Printhatshit/Prusa-i3-PTS/Freecad/Cuerpo extrusor.FCStd

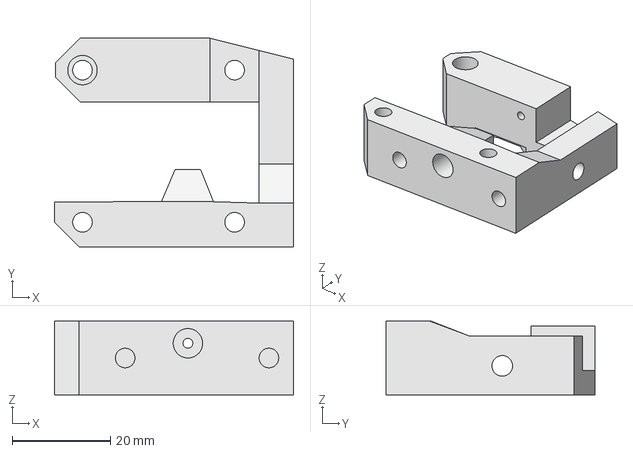
[picture p1: CAD file, 2015-06-19]
Freecad/Cuerpo extrusor.FCStd
48.7 x 42.5 x 15.0 mm
