Printhatshit/Prusa-i3-PTS/Stl/Prusa I3 PTS/Autolevel inductivo 16mm.stl

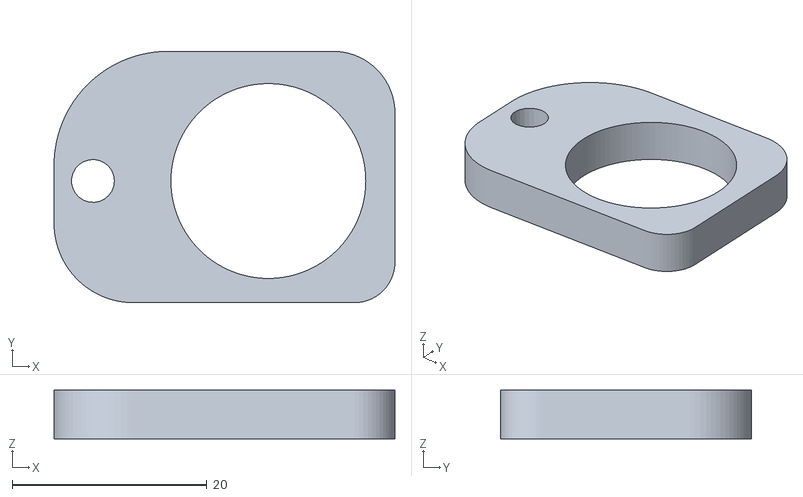
[picture p2: CAD file, 2015-07-31]
Stl/Prusa I3 PTS/Autolevel inductivo 16mm.stl
35.0 x 25.8 x 5.00
