Printhatshit/Prusa-i3-PTS/Stl/Prusa I3 PTS/Dual Extruder/X_carriage_dual_PTSone_extrude_A.stl

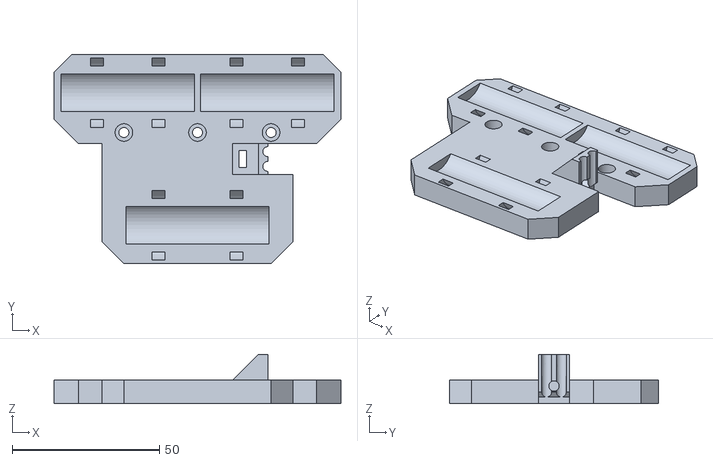
[picture p3: CAD file, 2015-01-19]
Stl/Prusa I3 PTS/Dual Extruder/X_carriage_dual_PTSone_extrude_A.stl
97.5 x 71.0 x 16.8
