Printhatshit/Prusa-i3-PTS/Stl/Prusa I3 PTS/Soporte bobina Filamento/soporte-bobina-printhatshit.stl

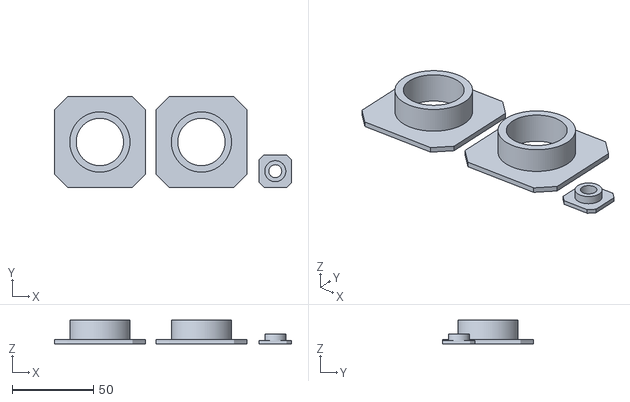
[picture p4: CAD file, 2015-09-02]
Stl/Prusa I3 PTS/Soporte bobina Filamento/soporte-bobina-printhatshit.stl
146.2 x 56.0 x 14.5
