Printhatshit/Prusa-i3-PTS/Freecad/Soporte Extrusor.FCStd

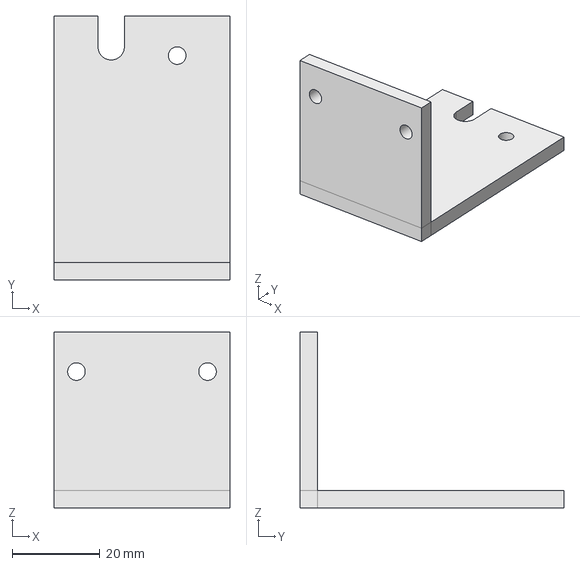
[picture p5: CAD file, 2015-06-16]
Freecad/Soporte Extrusor.FCStd
40.0 x 60.0 x 40.0 mm
