Printhatshit/Prusa-i3-PTS/Stl/Prusa I3 PTS/Dual Extruder/X_carriage_B.stl

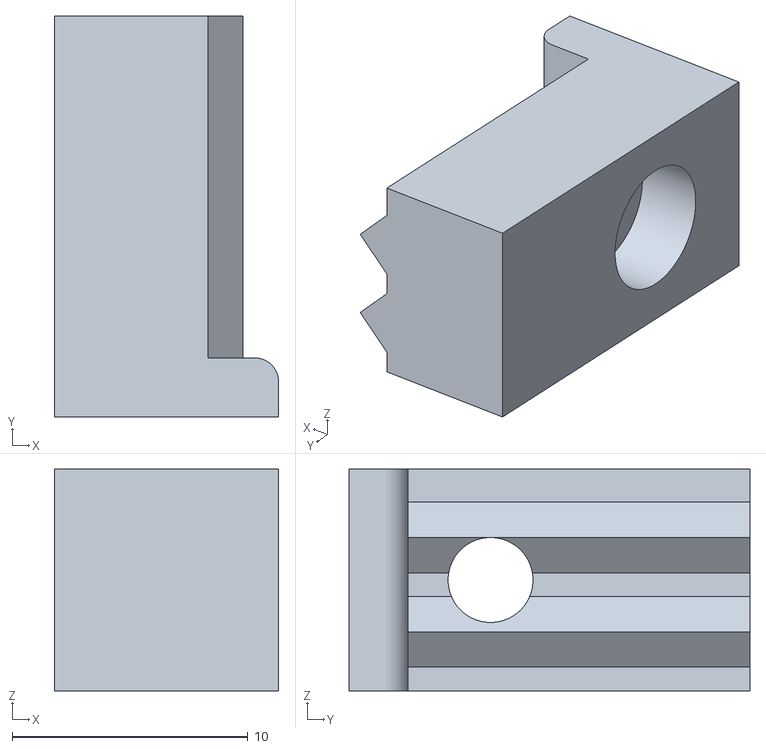
[picture p6: CAD file, 2015-01-13]
Stl/Prusa I3 PTS/Dual Extruder/X_carriage_B.stl
9.50 x 17.0 x 9.40
