Printhatshit/Prusa-i3-PTS/Stl/Prusa I3 PTS/lcd_front_Cover.stl

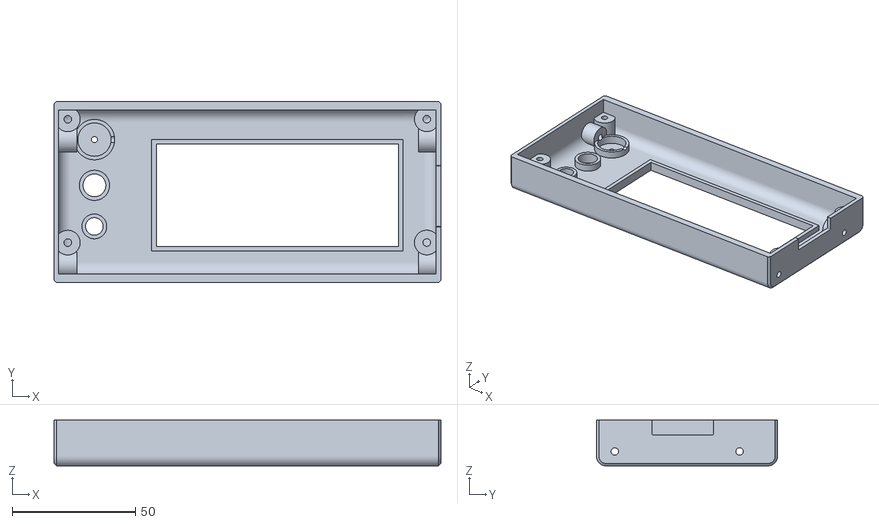
[picture p7: CAD file, 2015-06-12]
Stl/Prusa I3 PTS/lcd_front_Cover.stl
156.9 x 73.5 x 18.6
