Printhatshit/Prusa-i3-PTS/Stl/Prusa I3 PTS/Soporte bobina Filamento/soporte-bobina-m10.stl

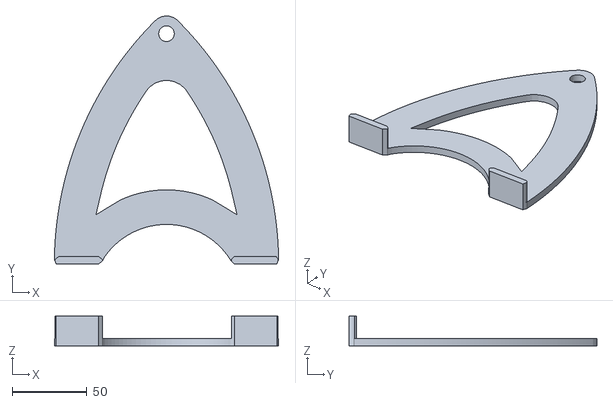
[picture p8: CAD file, 2015-06-17]
Stl/Prusa I3 PTS/Soporte bobina Filamento/soporte-bobina-m10.stl
150.0 x 165.9 x 20.0
