Printhatshit/Prusa-i3-PTS/Stl/Prusa I3 PTS/X_carriage_A_chain-M4-O .stl

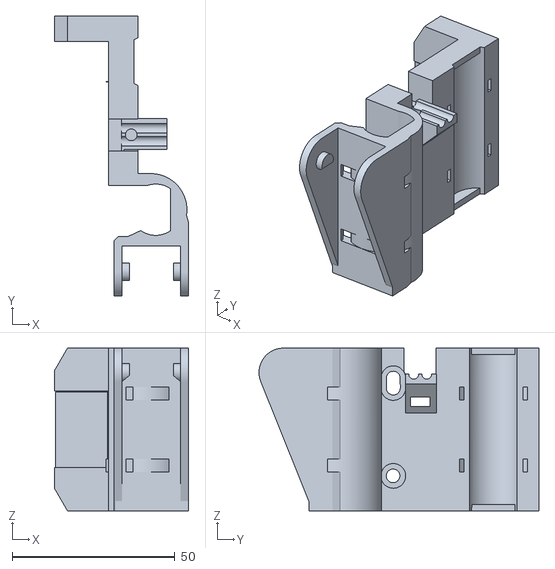
[picture p9: CAD file, 2015-06-12]
Stl/Prusa I3 PTS/X_carriage_A_chain-M4-O .stl
41.2 x 86.0 x 50.0
