Printhatshit/Prusa-i3-PTS/Stl/Prusa I3 PTS/lcd_Top_Case_FGD.stl

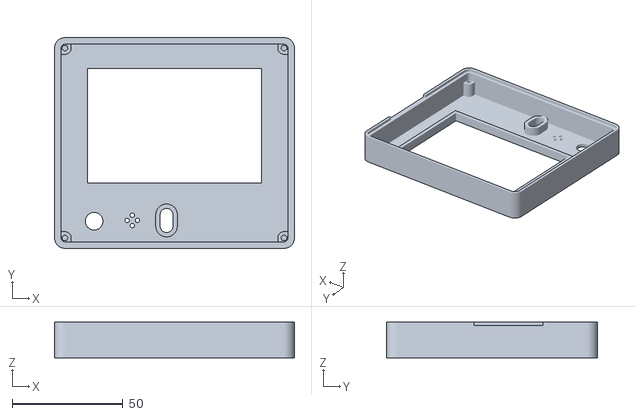
[picture p10: CAD file, 2015-03-03]
Stl/Prusa I3 PTS/lcd_Top_Case_FGD.stl
108.6 x 95.4 x 16.1
