Printhatshit/Prusa-i3-PTS/Stl/Prusa I3 PTS/y_tensioner_fixed_fixed.stl

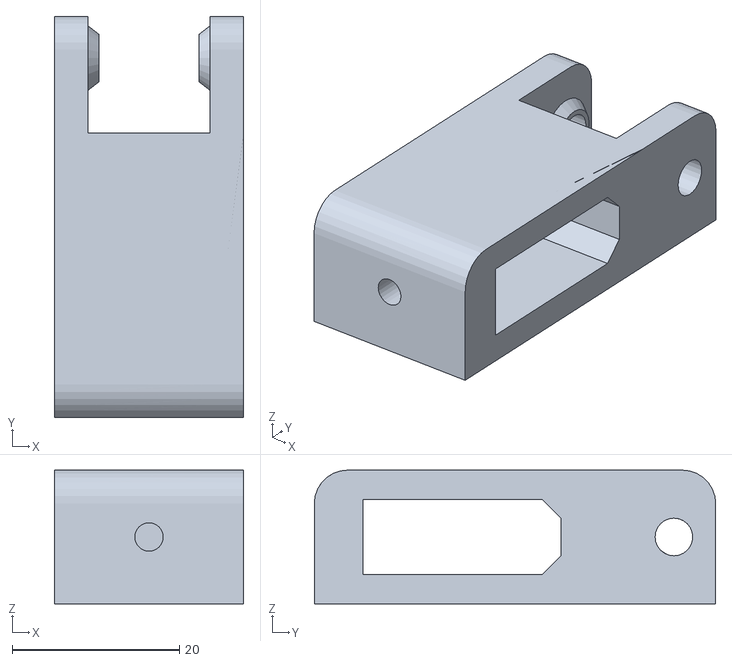
[picture p11: CAD file, 2015-03-03]
Stl/Prusa I3 PTS/y_tensioner_fixed_fixed.stl
22.6 x 48.0 x 16.0
