Printhatshit/Prusa-i3-PTS/Stl/Prusa I3 PTS/lcd_Bottom_Case_FGD_fixed.stl

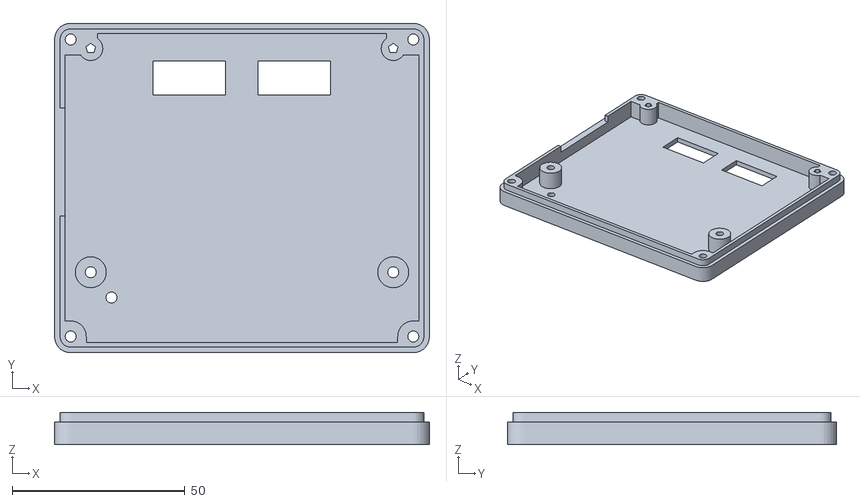
[picture p12: CAD file, 2015-03-03]
Stl/Prusa I3 PTS/lcd_Bottom_Case_FGD_fixed.stl
108.6 x 95.4 x 9.30
