Printhatshit/Prusa-i3-PTS/Stl/Prusa I3 PTS/X_carriage_A_chain_servo.stl

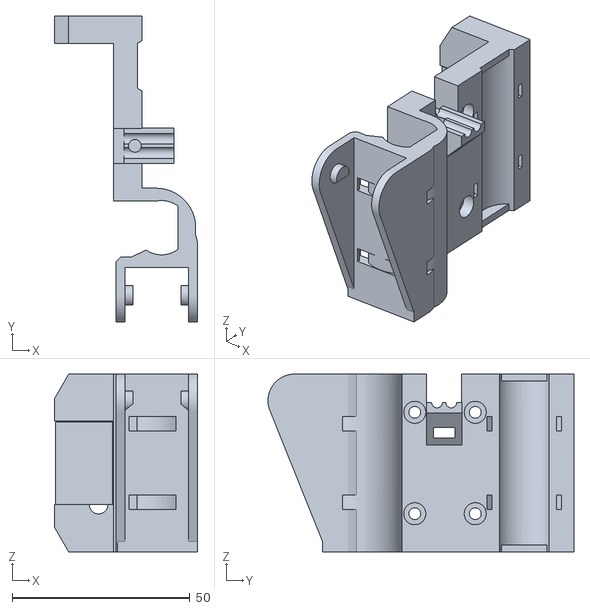
[picture p13: CAD file, 2015-03-03]
Stl/Prusa I3 PTS/X_carriage_A_chain_servo.stl
40.2 x 86.0 x 50.0
