Printhatshit/Prusa-i3-PTS/Stl/Prusa I3 PTS/X_end_Motor.stl

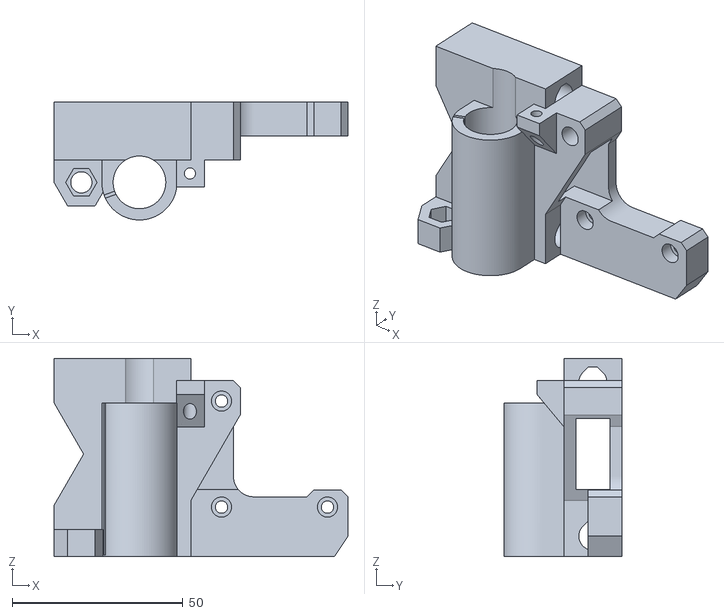
[picture p14: CAD file, 2015-03-03]
Stl/Prusa I3 PTS/X_end_Motor.stl
86.0 x 34.5 x 58.0
