Printhatshit/Prusa-i3-PTS/Stl/Prusa I3 PTS/cadena-electronica-definitivo_fixed.stl

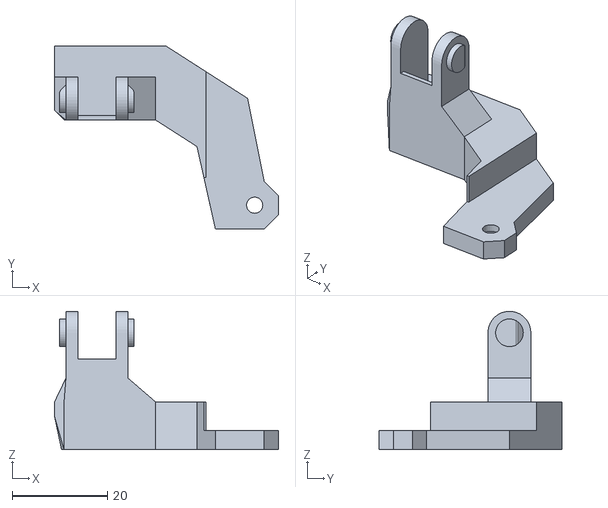
[picture p15: CAD file, 2015-03-03]
Stl/Prusa I3 PTS/cadena-electronica-definitivo_fixed.stl
47.0 x 38.4 x 29.0
