Printhatshit/Prusa-i3-PTS/Stl/Prusa I3 PTS/X_end_Idler_A.stl

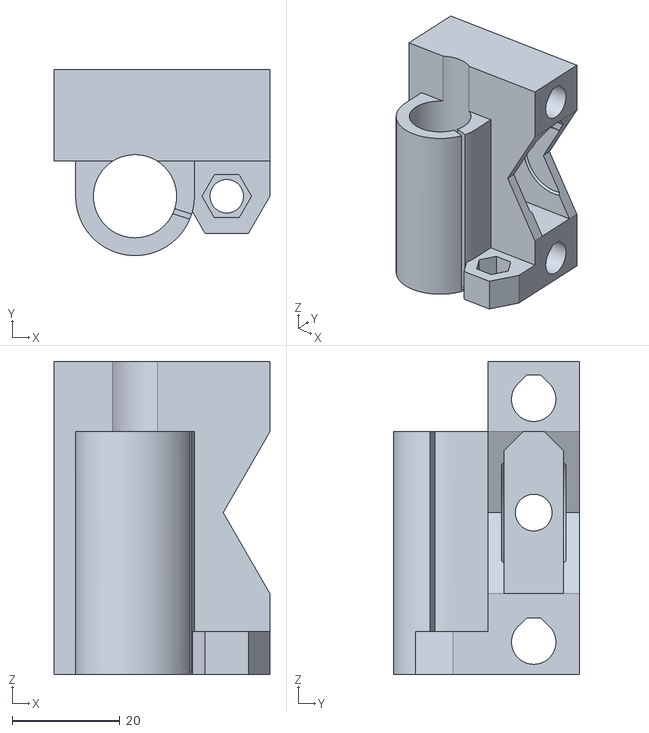
[picture p16: CAD file, 2015-03-03]
Stl/Prusa I3 PTS/X_end_Idler_A.stl
40.0 x 34.5 x 58.0
