Printhatshit/Prusa-i3-PTS/Stl/Prusa I3 PTS/boquilla-v3-fixed.STL

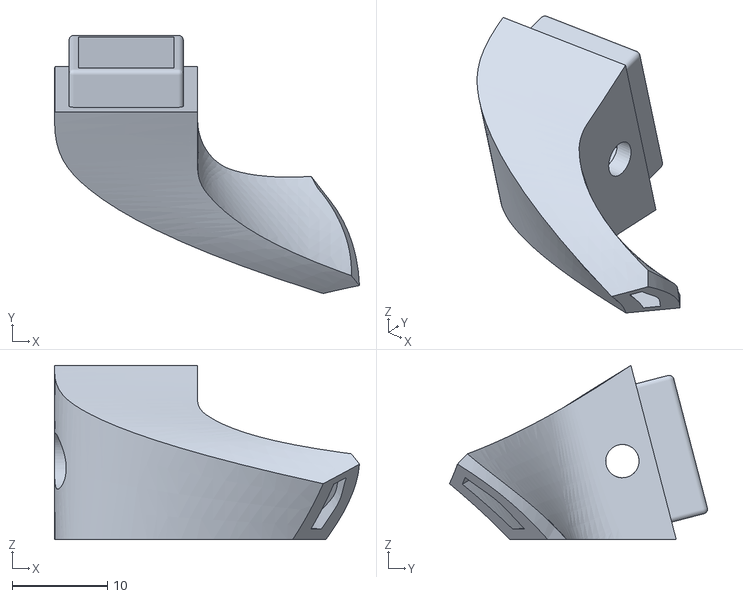
[picture p17: CAD file, 2015-01-21]
Stl/Prusa I3 PTS/boquilla-v3-fixed.STL
32.0 x 27.1 x 18.3
