Printhatshit/Prusa-i3-PTS/Stl/Prusa I3 PTS/R-Fan-support-v2.STL

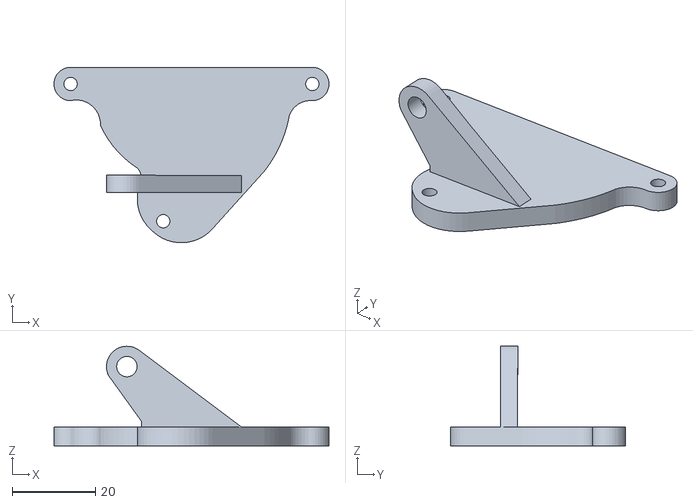
[picture p18: CAD file, 2015-01-21]
Stl/Prusa I3 PTS/R-Fan-support-v2.STL
66.0 x 42.1 x 23.9
