Printhatshit/Prusa-i3-PTS/Stl/Prusa I3 PTS/brazo-autolevel.stl

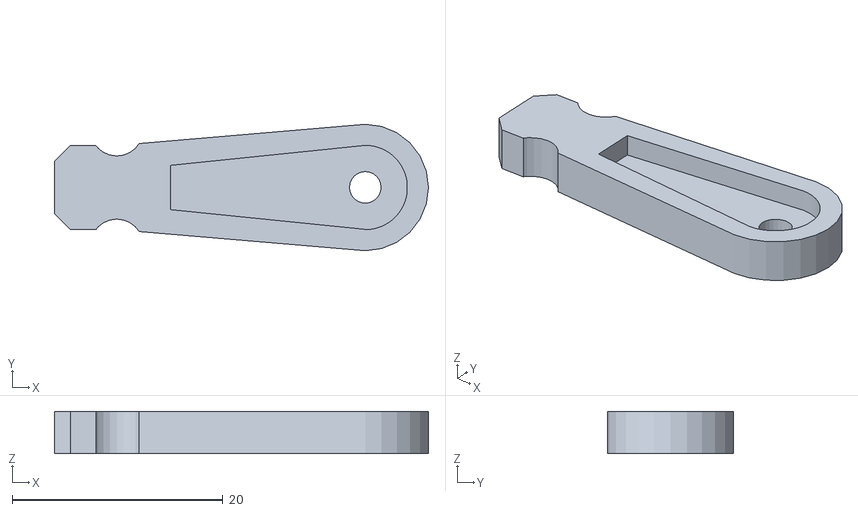
[picture p19: CAD file, 2015-01-19]
Stl/Prusa I3 PTS/brazo-autolevel.stl
35.5 x 12.0 x 4.00
