Printhatshit/Prusa-i3-PTS/Stl/Prusa I3 PTS/smartlcd_back.stl

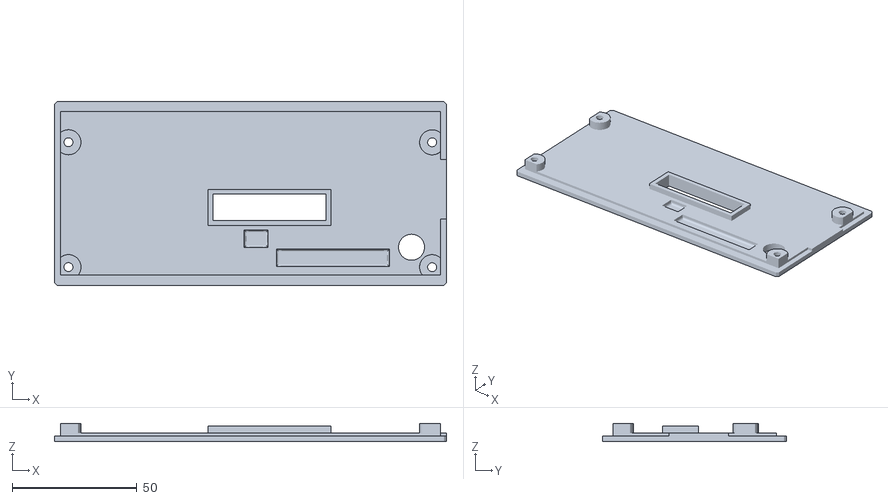
[picture p20: CAD file, 2015-01-19]
Stl/Prusa I3 PTS/smartlcd_back.stl
156.9 x 73.5 x 7.37
