Printhatshit/Prusa-i3-PTS/Stl/Prusa I3 PTS/endstop.stl

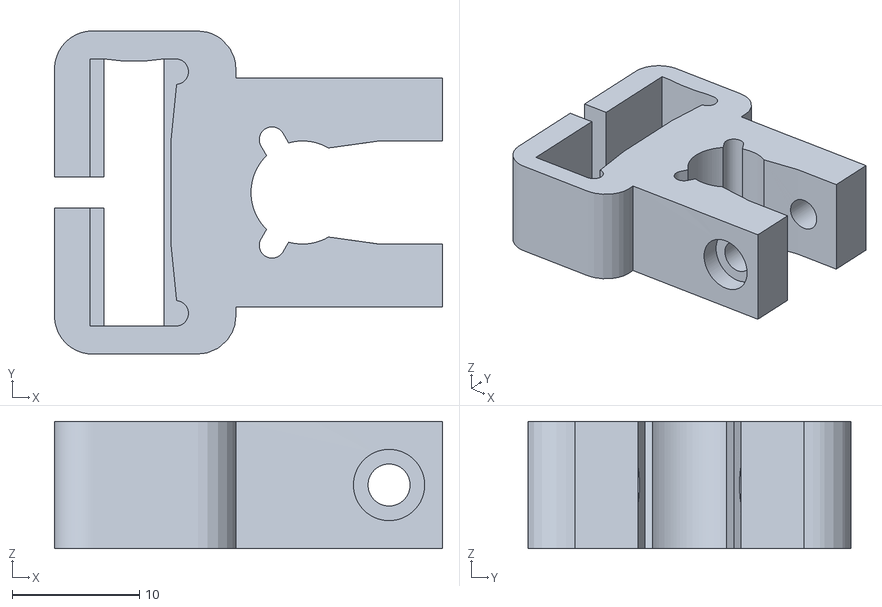
[picture p21: CAD file, 2015-01-19]
Stl/Prusa I3 PTS/endstop.stl
30.5 x 25.4 x 10.0
