Printhatshit/Prusa-i3-PTS/Stl/Prusa I3 PTS/lcd_frame_support-FIX.stl

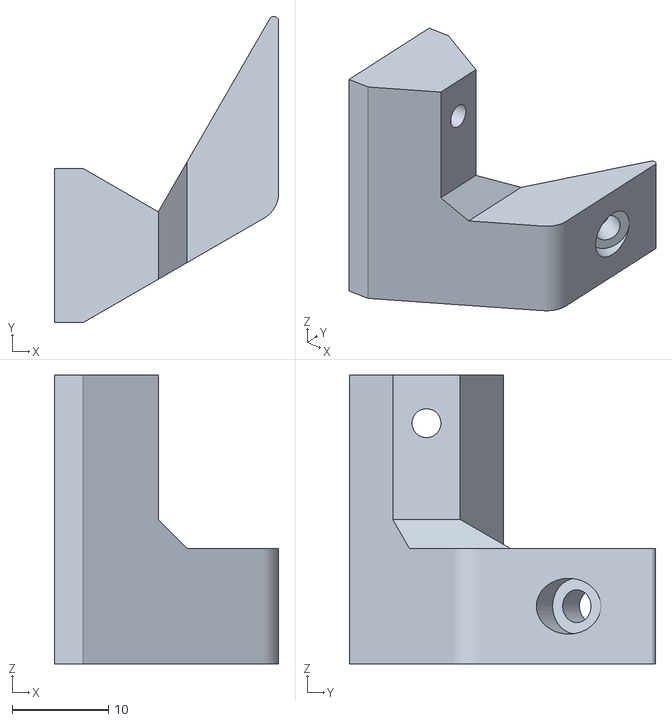
[picture p22: CAD file, 2015-01-16]
Stl/Prusa I3 PTS/lcd_frame_support-FIX.stl
23.3 x 31.8 x 30.0
