Printhatshit/Prusa-i3-PTS/Stl/Prusa I3 PTS/X_end_Idler_B_GT2_pulley.stl

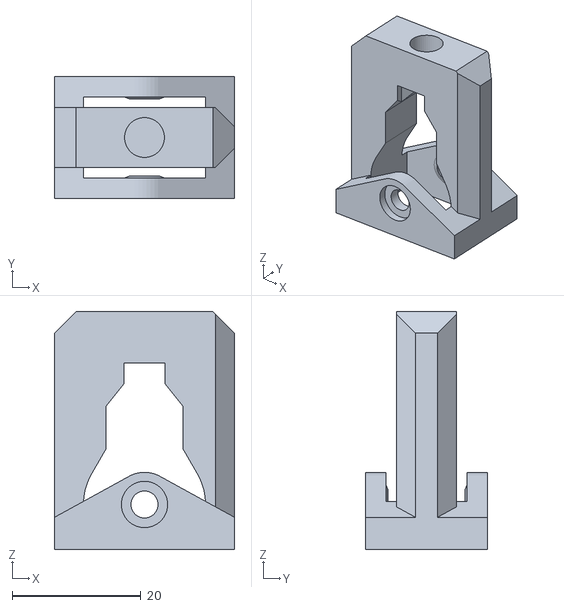
[picture p23: CAD file, 2015-01-13]
Stl/Prusa I3 PTS/X_end_Idler_B_GT2_pulley.stl
28.0 x 19.0 x 37.0
