Printhatshit/Prusa-i3-PTS/Stl/Prusa I3 PTS/cable_chain_X.stl

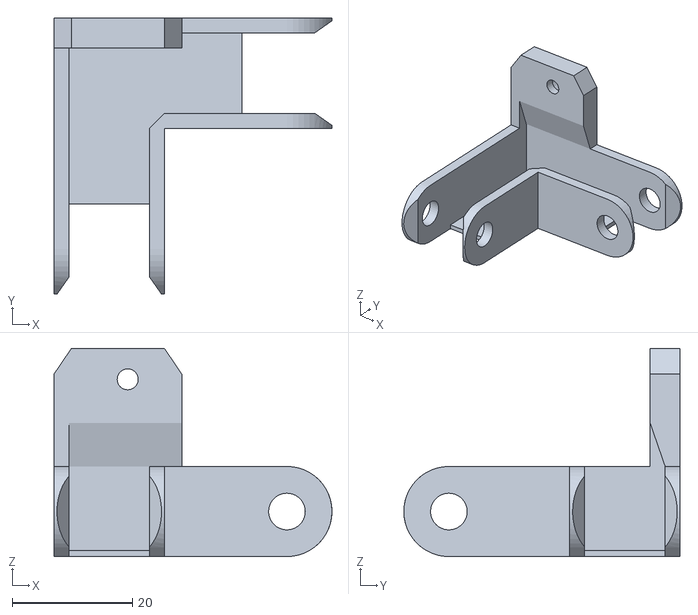
[picture p24: CAD file, 2015-01-13]
Stl/Prusa I3 PTS/cable_chain_X.stl
46.3 x 46.0 x 34.6
