Printhatshit/Prusa-i3-PTS/Stl/Prusa I3 PTS/Fan_support_B.stl

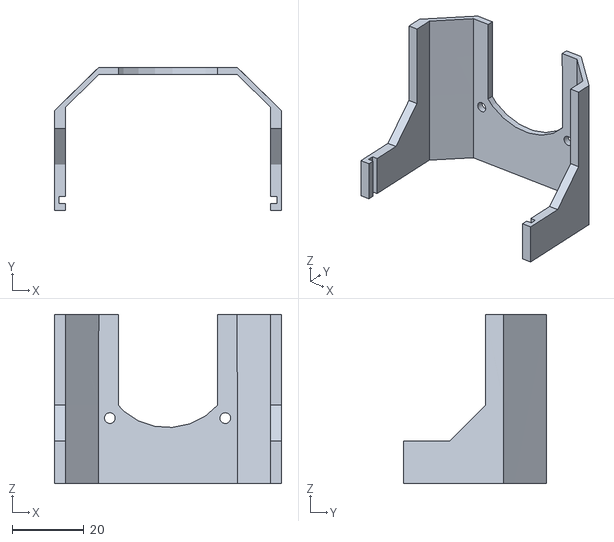
[picture p25: CAD file, 2015-01-13]
Stl/Prusa I3 PTS/Fan_support_B.stl
63.3 x 39.9 x 47.2
