Printhatshit/Prusa-i3-PTS/Stl/Prusa I3 PTS/Fan_support_A.stl

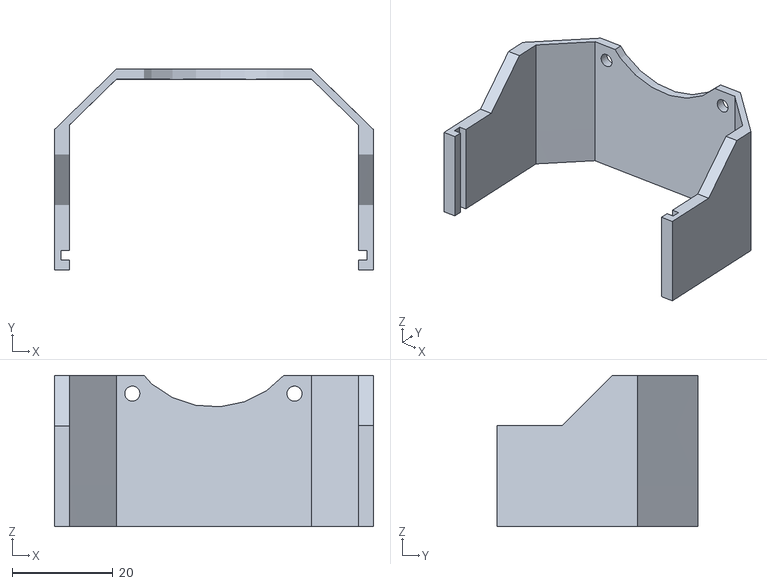
[picture p26: CAD file, 2015-01-13]
Stl/Prusa I3 PTS/Fan_support_A.stl
63.3 x 39.9 x 30.0
