Printhatshit/Prusa-i3-PTS/Stl/Prusa I3 PTS/Y_corner.stl

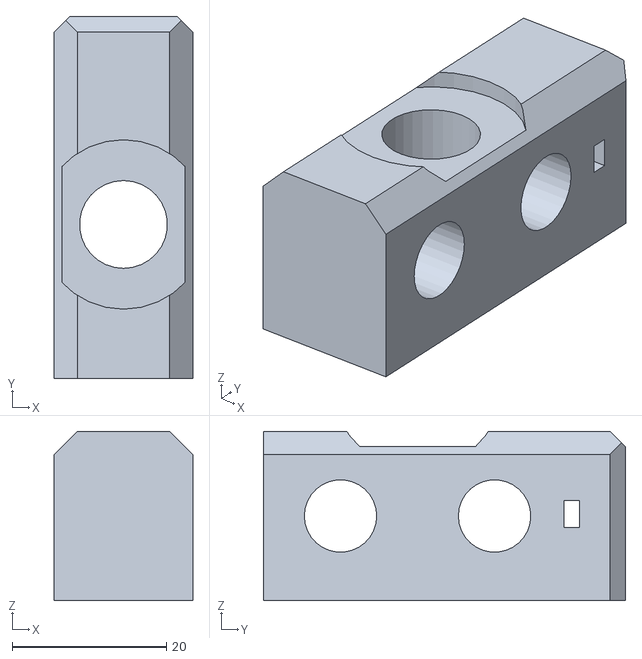
[picture p27: CAD file, 2015-01-13]
Stl/Prusa I3 PTS/Y_corner.stl
18.0 x 47.0 x 22.0
