Printhatshit/Prusa-i3-PTS/Stl/Prusa I3 PTS/cable_chain_Y.stl

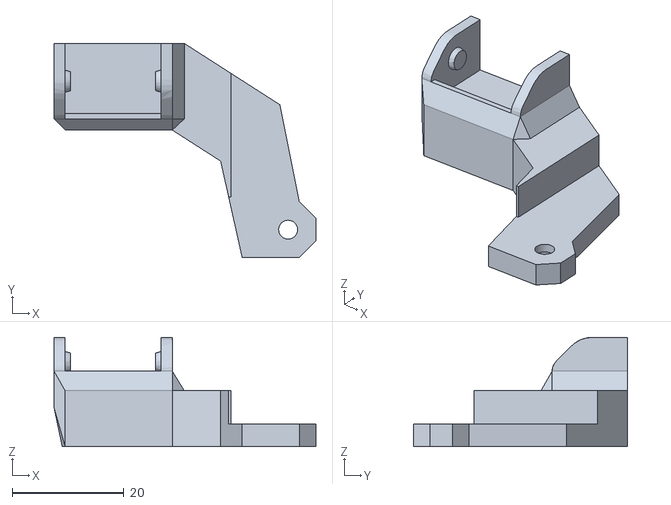
[picture p28: CAD file, 2014-11-26]
Stl/Prusa I3 PTS/cable_chain_Y.stl
47.0 x 38.4 x 19.6
