Printhatshit/Prusa-i3-PTS/Stl/Prusa I3 PTS/Y_motor_endstop.stl

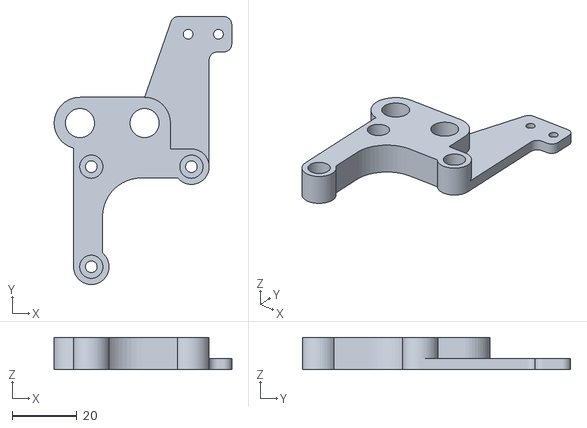
[picture p29: CAD file, 2014-11-26]
Stl/Prusa I3 PTS/Y_motor_endstop.stl
55.0 x 83.0 x 10.00
