Printhatshit/Prusa-i3-PTS/Stl/Prusa I3 PTS/Y_belt_ holder.stl

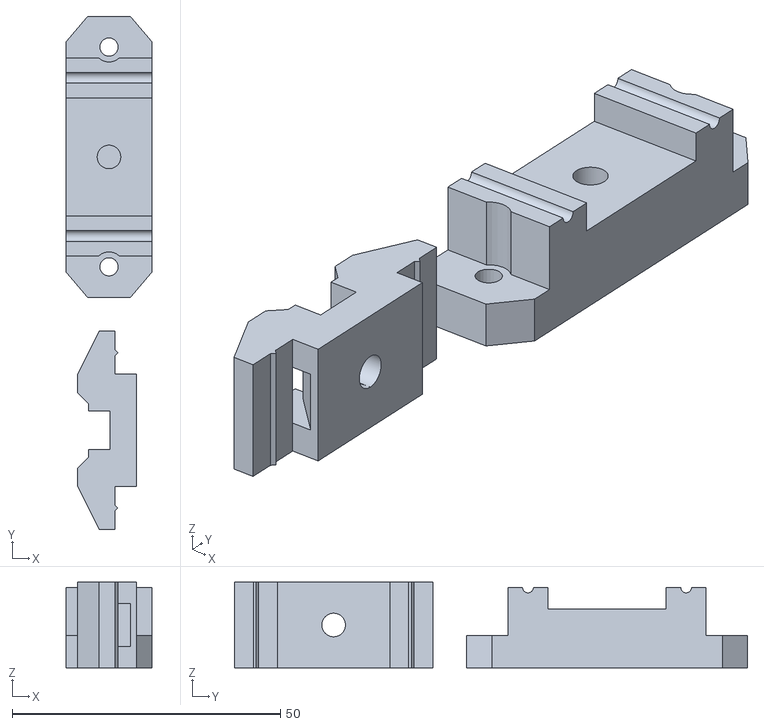
[picture p30: CAD file, 2014-11-26]
Stl/Prusa I3 PTS/Y_belt_ holder.stl
16.0 x 95.7 x 16.0
