Printhatshit/Prusa-i3-PTS/Stl/Prusa I3 PTS/z_bottom.stl

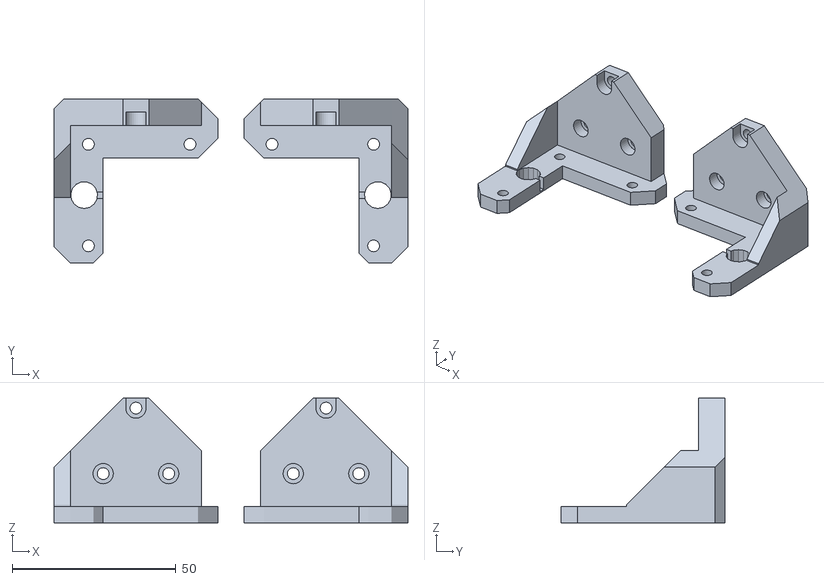
[picture p31: CAD file, 2014-11-26]
Stl/Prusa I3 PTS/z_bottom.stl
108.0 x 50.0 x 38.0
