Printhatshit/Prusa-i3-PTS/Stl/Prusa I3 PTS/power_supply_support_up.stl

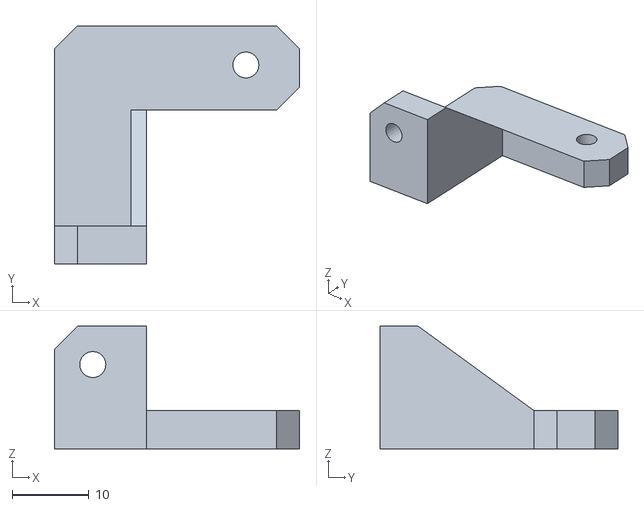
[picture p32: CAD file, 2014-11-26]
Stl/Prusa I3 PTS/power_supply_support_up.stl
32.0 x 31.1 x 16.0
