Printhatshit/Prusa-i3-PTS/Stl/Prusa I3 PTS/Arduino_ramps_proteccion_A.stl

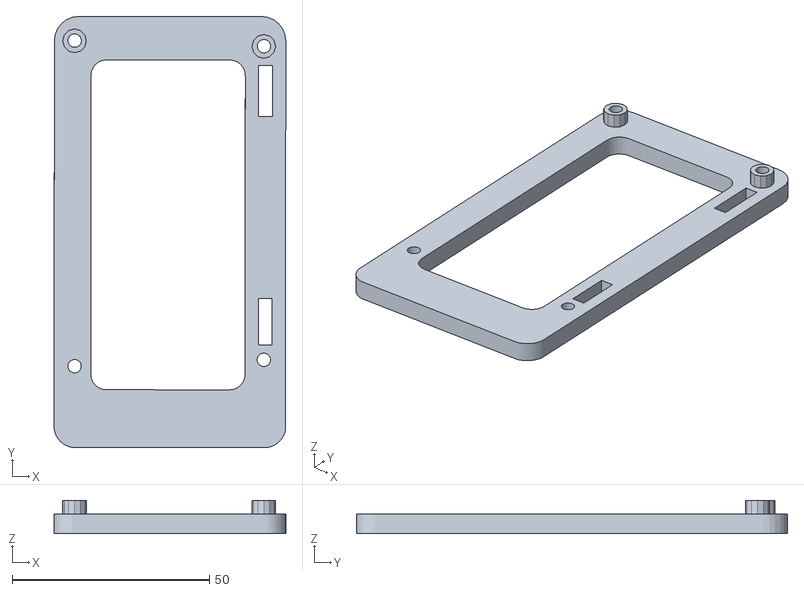
[picture p33: CAD file, 2014-11-26]
Stl/Prusa I3 PTS/Arduino_ramps_proteccion_A.stl
58.7 x 109.3 x 8.46
