Printhatshit/Prusa-i3-PTS/Stl/Prusa I3 PTS/Arduino_ramps_proteccion_B.stl

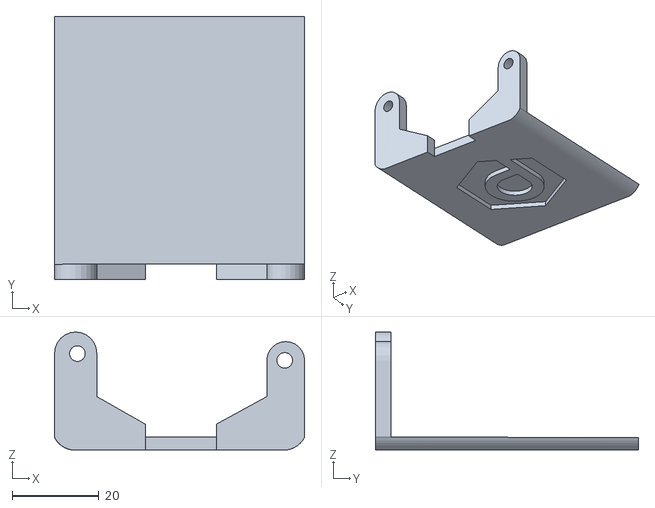
[picture p34: CAD file, 2014-11-26]
Stl/Prusa I3 PTS/Arduino_ramps_proteccion_B.stl
57.6 x 60.5 x 27.1
