Printhatshit/Prusa-i3-PTS/Stl/Prusa I3 PTS/z_top.stl

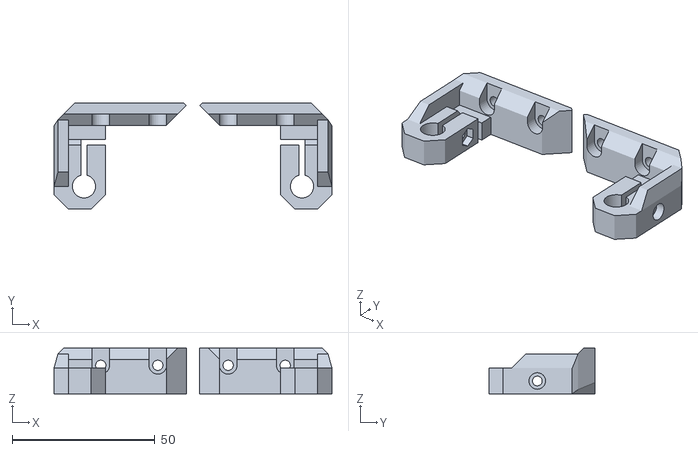
[picture p35: CAD file, 2014-11-26]
Stl/Prusa I3 PTS/z_top.stl
97.4 x 37.3 x 16.0
