Printhatshit/Prusa-i3-PTS/Stl/Prusa I3 PTS/power_supply_support_down.stl

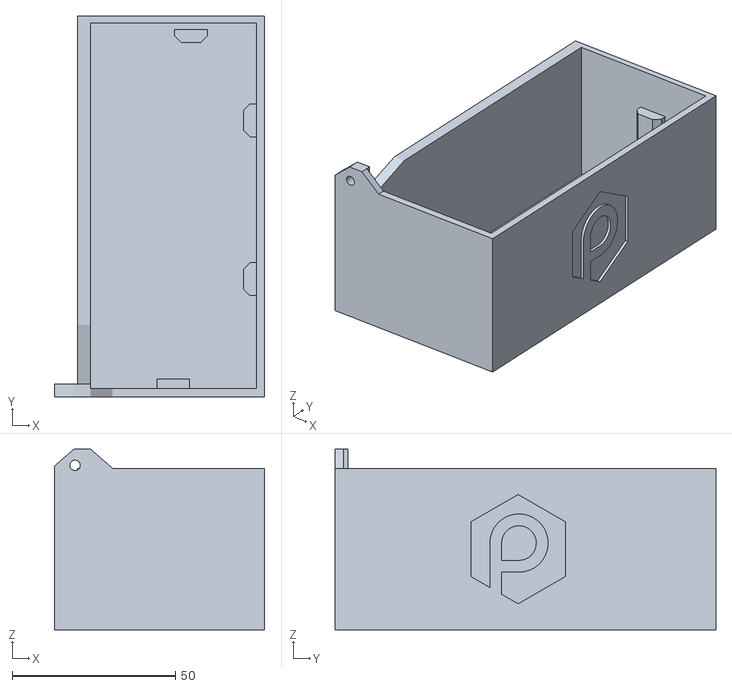
[picture p36: CAD file, 2014-11-26]
Stl/Prusa I3 PTS/power_supply_support_down.stl
64.3 x 116.6 x 55.4
