Printhatshit/Prusa-i3-PTS/(list of files, cad)

Other CAD files:
Stl/Prusa I3 PTS/Soporte bobina Filamento/soporte-bobina-m8.stl
Stl/Prusa I3 PTS/X_carriage_A_chain-O.stl
