Printhatshit/Prusa-i3-PTS/(commit log)

2015-01-13 Fixed parts
    [X_carriage_A_chain_fixed.stl, X_carriage_B.stl, X_carriage_servo_fixed.stl, X_end_Idler_A.stl, X_end_Idler_A_.stl, X_end_Idler_B_GT2_pulley.stl, X_end_Motor.stl, Y-corner.stl]
2015-01-13 Fixed
    Part rotated
    [X_carriage_dual_PTSone_extrude_A.stl]
2015-04-01 New Files
    Fan Layer
    [R-Fan-support-v2.STL, boquilla-v3-fixed.STL]
2015-09-02 NEW
    Soporte para las nuevas bobinas de filamento.
    [soporte-bobina-printhatshit.stl]
